KiLLuuuhh/solar-display/docs/mockup.png

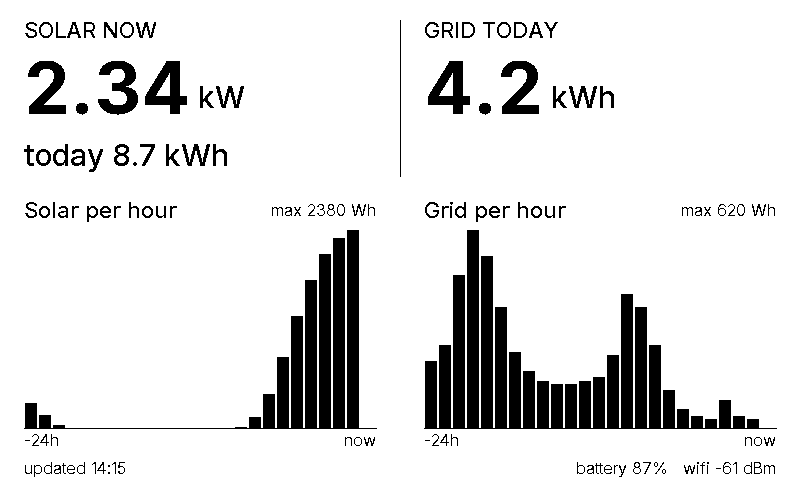
docs/mockup.png
